wafer-space/chip-on-board-wire-bonded-pcbs/run-2/1x0p5-cob/mezzanine-1x0p5.kicad_pcb

## KiCad design run-2/1x0p5-cob/mezzanine-1x0p5.kicad_pcb (2026-10-08)

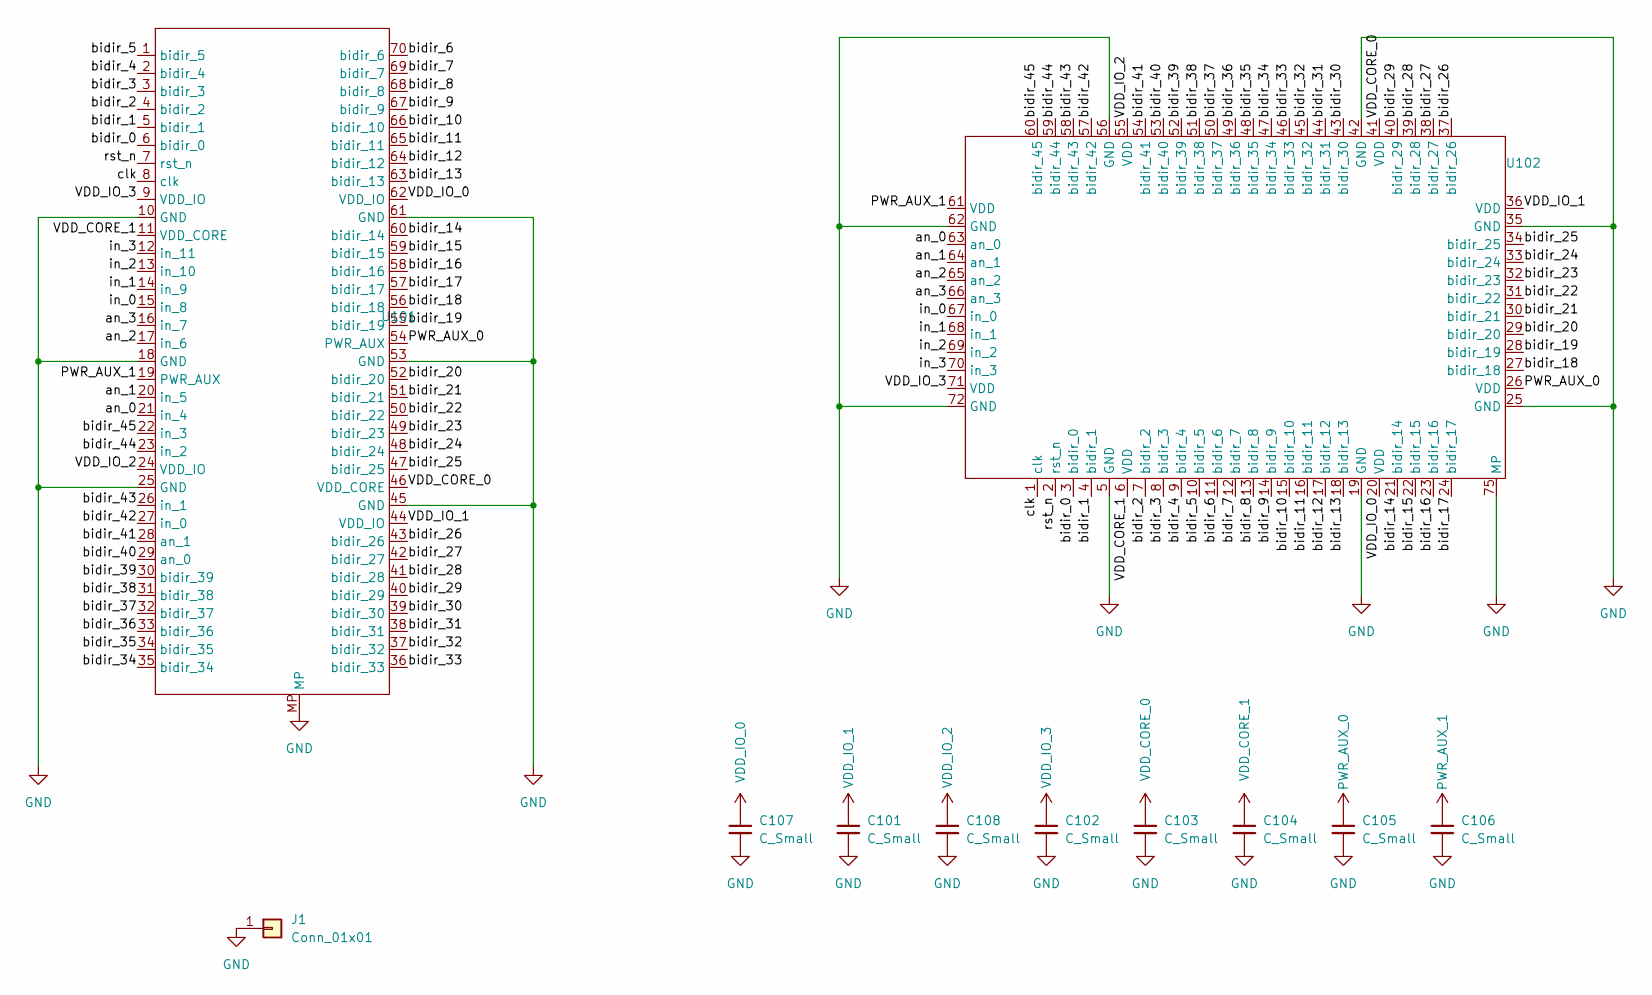
[picture p6: schematic mezzanine-1x0p5.kicad_sch, Wafer Space 1x0p5 mezzanine]

Parts:
C101, C102, C103, C104, C105, C106, C107, C108: C_Small; C_0201_0603Metric
J1: Conn_01x01; pin1_fiducial
U101: CONN-SMD_70P-P0.40_HCTL_HC-PBB40C-70DP-0.4V-02
U102: waferspace_1x0p5_padring_v0.1

Connections:
/an_0: U101.21 (in_4), U102.63 (an_0)
/an_1: U101.20 (in_5), U102.64 (an_1)
/an_2: U101.17 (in_6), U102.65 (an_2)
/an_3: U101.16 (in_7), U102.66 (an_3)
/bidir_0: U101.6 (bidir_0), U102.3 (bidir_0)
/bidir_1: U101.5 (bidir_1), U102.4 (bidir_1)
/bidir_2: U101.4 (bidir_2), U102.7 (bidir_2)
/bidir_3: U101.3 (bidir_3), U102.8 (bidir_3)
/bidir_4: U101.2 (bidir_4), U102.9 (bidir_4)
/bidir_5: U101.1 (bidir_5), U102.10 (bidir_5)
/bidir_6: U101.70 (bidir_6), U102.11 (bidir_6)
/bidir_7: U101.69 (bidir_7), U102.12 (bidir_7)
/bidir_8: U101.68 (bidir_8), U102.13 (bidir_8)
/bidir_9: U101.67 (bidir_9), U102.14 (bidir_9)
/bidir_10: U101.66 (bidir_10), U102.15 (bidir_10)
/bidir_11: U101.65 (bidir_11), U102.16 (bidir_11)
/bidir_12: U101.64 (bidir_12), U102.17 (bidir_12)
/bidir_13: U101.63 (bidir_13), U102.18 (bidir_13)
/bidir_14: U101.60 (bidir_14), U102.21 (bidir_14)
/bidir_15: U101.59 (bidir_15), U102.22 (bidir_15)
/bidir_16: U101.58 (bidir_16), U102.23 (bidir_16)
/bidir_17: U101.57 (bidir_17), U102.24 (bidir_17)
/bidir_18: U101.56 (bidir_18), U102.27 (bidir_18)
/bidir_19: U101.55 (bidir_19), U102.28 (bidir_19)
/bidir_20: U101.52 (bidir_20), U102.29 (bidir_20)
/bidir_21: U101.51 (bidir_21), U102.30 (bidir_21)
/bidir_22: U101.50 (bidir_22), U102.31 (bidir_22)
/bidir_23: U101.49 (bidir_23), U102.32 (bidir_23)
/bidir_24: U101.48 (bidir_24), U102.33 (bidir_24)
/bidir_25: U101.47 (bidir_25), U102.34 (bidir_25)
/bidir_26: U101.43 (bidir_26), U102.37 (bidir_26)
/bidir_27: U101.42 (bidir_27), U102.38 (bidir_27)
/bidir_28: U101.41 (bidir_28), U102.39 (bidir_28)
/bidir_29: U101.40 (bidir_29), U102.40 (bidir_29)
/bidir_30: U101.39 (bidir_30), U102.43 (bidir_30)
/bidir_31: U101.38 (bidir_31), U102.44 (bidir_31)
/bidir_32: U101.37 (bidir_32), U102.45 (bidir_32)
/bidir_33: U101.36 (bidir_33), U102.46 (bidir_33)
/bidir_34: U101.35 (bidir_34), U102.47 (bidir_34)
/bidir_35: U101.34 (bidir_35), U102.48 (bidir_35)
/bidir_36: U101.33 (bidir_36), U102.49 (bidir_36)
/bidir_37: U101.32 (bidir_37), U102.50 (bidir_37)
/bidir_38: U101.31 (bidir_38), U102.51 (bidir_38)
/bidir_39: U101.30 (bidir_39), U102.52 (bidir_39)
/bidir_40: U101.29 (an_0), U102.53 (bidir_40)
/bidir_41: U101.28 (an_1), U102.54 (bidir_41)
/bidir_42: U101.27 (in_0), U102.57 (bidir_42)
/bidir_43: U101.26 (in_1), U102.58 (bidir_43)
/bidir_44: U101.23 (in_2), U102.59 (bidir_44)
/bidir_45: U101.22 (in_3), U102.60 (bidir_45)
/clk: U101.8 (clk), U102.1 (clk)
/in_0: U101.15 (in_8), U102.67 (in_0)
/in_1: U101.14 (in_9), U102.68 (in_1)
/in_2: U101.13 (in_10), U102.69 (in_2)
/in_3: U101.12 (in_11), U102.70 (in_3)
/rst_n: U101.7 (rst_n), U102.2 (rst_n)
GND: C101.2, C102.2, C103.2, C104.2, C105.2, C106.2, C107.2, C108.2, J1.1 (Pin_1_1), U101.10 (GND), U101.18 (GND), U101.25 (GND), U101.45 (GND), U101.53 (GND), U101.61 (GND), U101.MP, U102.5 (GND), U102.19 (GND), U102.25 (GND), U102.35 (GND), U102.42 (GND), U102.56 (GND), U102.62 (GND), U102.72 (GND), U102.75 (MP)
PWR_AUX_0: C105.1, U101.54 (PWR_AUX), U102.26 (VDD)
PWR_AUX_1: C106.1, U101.19 (PWR_AUX), U102.61 (VDD)
VDD_CORE_0: C103.1, U101.46 (VDD_CORE), U102.41 (VDD)
VDD_CORE_1: C104.1, U101.11 (VDD_CORE), U102.6 (VDD)
VDD_IO_0: C107.1, U101.62 (VDD_IO), U102.20 (VDD)
VDD_IO_1: C101.1, U101.44 (VDD_IO), U102.36 (VDD)
VDD_IO_2: C108.1, U101.24 (VDD_IO), U102.55 (VDD)
VDD_IO_3: C102.1, U101.9 (VDD_IO), U102.71 (VDD)

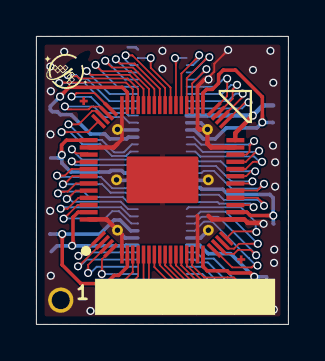
[picture p7: board mezzanine-1x0p5.kicad_pcb from above]

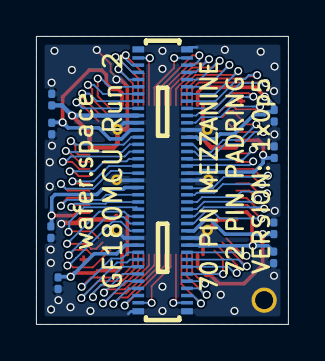
[picture p8: board mezzanine-1x0p5.kicad_pcb from below]

Board: 4 copper layers, 14.0 x 16.0 mm, 11 parts (9 on the bottom side), 65 nets.
