wafer-space/chip-on-board-wire-bonded-pcbs/run-1/motherboards/motherboards.kicad_pcb

## KiCad design run-1/motherboards/motherboards.kicad_pcb (2026-06-16)

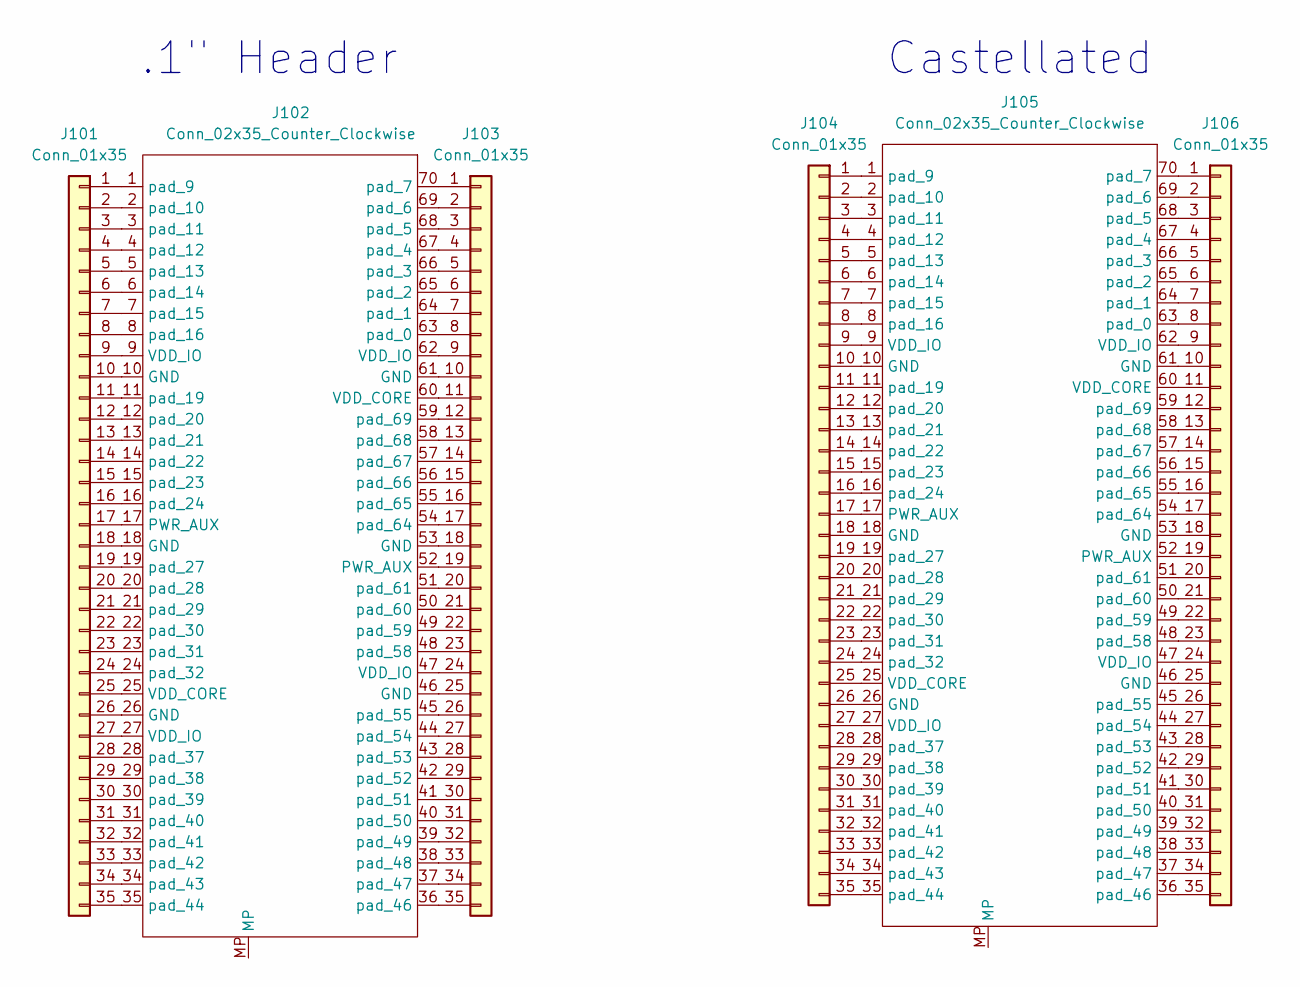
[picture p9: schematic motherboards.kicad_sch]

Parts:
J101, J103: Conn_01x35; PinHeader_1x35_P2.54mm_Vertical
J102, J105: Conn_02x35_Counter_Clockwise; CONN-SMD_70P-P0.40_HCTL_HC-PBB40C-70DP-0.4V-02
J104, J106: Conn_01x35; castellated_1mmx35

Connections:
unnamed: J101.1, J102.1 (pad_9)
unnamed: J101.2, J102.2 (pad_10)
unnamed: J101.3, J102.3 (pad_11)
unnamed: J101.4, J102.4 (pad_12)
unnamed: J101.5, J102.5 (pad_13)
unnamed: J101.6, J102.6 (pad_14)
unnamed: J101.7, J102.7 (pad_15)
unnamed: J101.8, J102.8 (pad_16)
unnamed: J101.9, J102.9 (VDD_IO)
unnamed: J101.10, J102.10 (GND)
unnamed: J101.11, J102.11 (pad_19)
unnamed: J101.12, J102.12 (pad_20)
unnamed: J101.13, J102.13 (pad_21)
unnamed: J101.14, J102.14 (pad_22)
unnamed: J101.15, J102.15 (pad_23)
unnamed: J101.16, J102.16 (pad_24)
unnamed: J101.17, J102.17 (PWR_AUX)
unnamed: J101.18, J102.18 (GND)
unnamed: J101.19, J102.19 (pad_27)
unnamed: J101.20, J102.20 (pad_28)
unnamed: J101.21, J102.21 (pad_29)
unnamed: J101.22, J102.22 (pad_30)
unnamed: J101.23, J102.23 (pad_31)
unnamed: J101.24, J102.24 (pad_32)
unnamed: J101.25, J102.25 (VDD_CORE)
unnamed: J101.26, J102.26 (GND)
unnamed: J101.27, J102.27 (VDD_IO)
unnamed: J101.28, J102.28 (pad_37)
unnamed: J101.29, J102.29 (pad_38)
unnamed: J101.30, J102.30 (pad_39)
unnamed: J101.31, J102.31 (pad_40)
unnamed: J101.32, J102.32 (pad_41)
unnamed: J101.33, J102.33 (pad_42)
unnamed: J101.34, J102.34 (pad_43)
unnamed: J101.35, J102.35 (pad_44)
unnamed: J102.63 (pad_0), J103.8
unnamed: J102.64 (pad_1), J103.7
unnamed: J102.65 (pad_2), J103.6
unnamed: J102.66 (pad_3), J103.5
unnamed: J102.67 (pad_4), J103.4
unnamed: J102.68 (pad_5), J103.3
unnamed: J102.69 (pad_6), J103.2
unnamed: J102.70 (pad_7), J103.1
unnamed: J102.36 (pad_46), J103.35
unnamed: J102.37 (pad_47), J103.34
unnamed: J102.38 (pad_48), J103.33
unnamed: J102.39 (pad_49), J103.32
unnamed: J102.40 (pad_50), J103.31
unnamed: J102.41 (pad_51), J103.30
unnamed: J102.42 (pad_52), J103.29
unnamed: J102.43 (pad_53), J103.28
unnamed: J102.44 (pad_54), J103.27
unnamed: J102.45 (pad_55), J103.26
unnamed: J102.48 (pad_58), J103.23
unnamed: J102.49 (pad_59), J103.22
unnamed: J102.50 (pad_60), J103.21
unnamed: J102.51 (pad_61), J103.20
unnamed: J102.54 (pad_64), J103.17
unnamed: J102.55 (pad_65), J103.16
unnamed: J102.56 (pad_66), J103.15
unnamed: J102.57 (pad_67), J103.14
unnamed: J102.58 (pad_68), J103.13
unnamed: J102.59 (pad_69), J103.12
unnamed: J102.62 (VDD_IO), J103.9
unnamed: J102.61 (GND), J103.10
unnamed: J102.60 (VDD_CORE), J103.11
unnamed: J102.53 (GND), J103.18
unnamed: J102.52 (PWR_AUX), J103.19
unnamed: J102.47 (VDD_IO), J103.24
unnamed: J102.46 (GND), J103.25
unnamed: J104.1, J105.1 (pad_9)
unnamed: J104.2, J105.2 (pad_10)
unnamed: J104.3, J105.3 (pad_11)
unnamed: J104.4, J105.4 (pad_12)
unnamed: J104.5, J105.5 (pad_13)
unnamed: J104.6, J105.6 (pad_14)
unnamed: J104.7, J105.7 (pad_15)
unnamed: J104.8, J105.8 (pad_16)
unnamed: J104.9, J105.9 (VDD_IO)
unnamed: J104.10, J105.10 (GND)
unnamed: J104.11, J105.11 (pad_19)
unnamed: J104.12, J105.12 (pad_20)
unnamed: J104.13, J105.13 (pad_21)
unnamed: J104.14, J105.14 (pad_22)
unnamed: J104.15, J105.15 (pad_23)
unnamed: J104.16, J105.16 (pad_24)
unnamed: J104.17, J105.17 (PWR_AUX)
unnamed: J104.18, J105.18 (GND)
unnamed: J104.19, J105.19 (pad_27)
unnamed: J104.20, J105.20 (pad_28)
unnamed: J104.21, J105.21 (pad_29)
unnamed: J104.22, J105.22 (pad_30)
unnamed: J104.23, J105.23 (pad_31)
unnamed: J104.24, J105.24 (pad_32)
unnamed: J104.25, J105.25 (VDD_CORE)
unnamed: J104.26, J105.26 (GND)
unnamed: J104.27, J105.27 (VDD_IO)
unnamed: J104.28, J105.28 (pad_37)
unnamed: J104.29, J105.29 (pad_38)
unnamed: J104.30, J105.30 (pad_39)
unnamed: J104.31, J105.31 (pad_40)
unnamed: J104.32, J105.32 (pad_41)
unnamed: J104.33, J105.33 (pad_42)
unnamed: J104.34, J105.34 (pad_43)
unnamed: J104.35, J105.35 (pad_44)
unnamed: J105.63 (pad_0), J106.8
unnamed: J105.64 (pad_1), J106.7
unnamed: J105.65 (pad_2), J106.6
unnamed: J105.66 (pad_3), J106.5
unnamed: J105.67 (pad_4), J106.4
unnamed: J105.68 (pad_5), J106.3
unnamed: J105.69 (pad_6), J106.2
unnamed: J105.70 (pad_7), J106.1
unnamed: J105.36 (pad_46), J106.35
unnamed: J105.37 (pad_47), J106.34
unnamed: J105.38 (pad_48), J106.33
unnamed: J105.39 (pad_49), J106.32
unnamed: J105.40 (pad_50), J106.31
unnamed: J105.41 (pad_51), J106.30
unnamed: J105.42 (pad_52), J106.29
unnamed: J105.43 (pad_53), J106.28
unnamed: J105.44 (pad_54), J106.27
unnamed: J105.45 (pad_55), J106.26
unnamed: J105.48 (pad_58), J106.23
unnamed: J105.49 (pad_59), J106.22
unnamed: J105.50 (pad_60), J106.21
unnamed: J105.51 (pad_61), J106.20
unnamed: J105.54 (pad_64), J106.17
unnamed: J105.55 (pad_65), J106.16
unnamed: J105.56 (pad_66), J106.15
unnamed: J105.57 (pad_67), J106.14
unnamed: J105.58 (pad_68), J106.13
unnamed: J105.59 (pad_69), J106.12
unnamed: J105.62 (VDD_IO), J106.9
unnamed: J105.61 (GND), J106.10
unnamed: J105.60 (VDD_CORE), J106.11
unnamed: J105.53 (GND), J106.18
unnamed: J105.52 (PWR_AUX), J106.19
unnamed: J105.47 (VDD_IO), J106.24
unnamed: J105.46 (GND), J106.25

Notes on the sheet:
Castellated
.1" Header

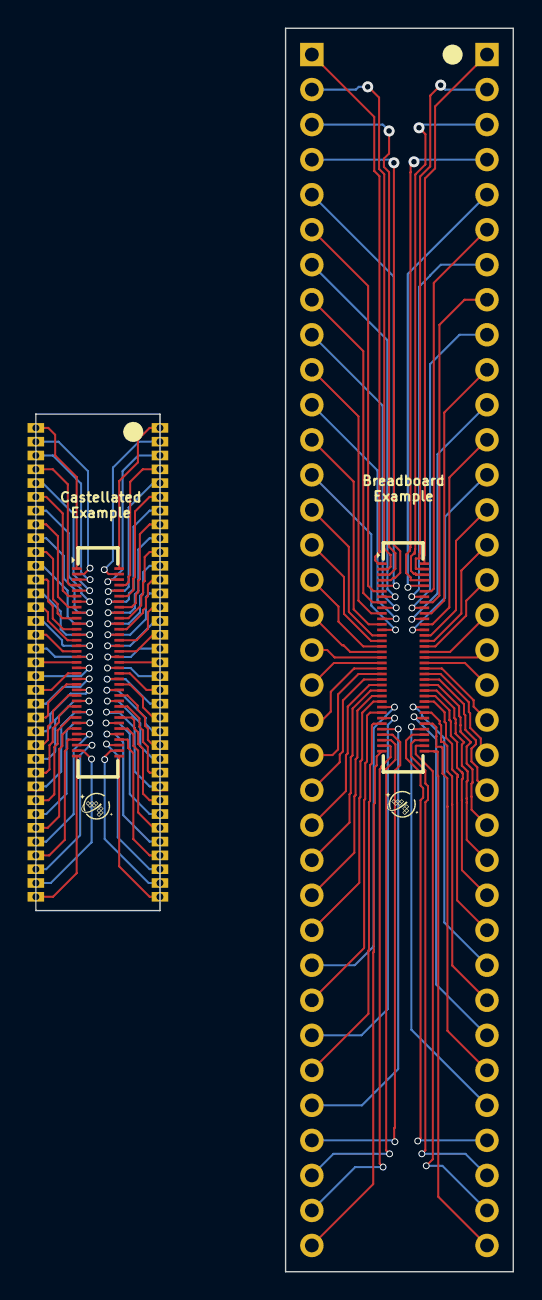
[picture p10: board run-1/motherboards/motherboards.kicad_pcb from above]

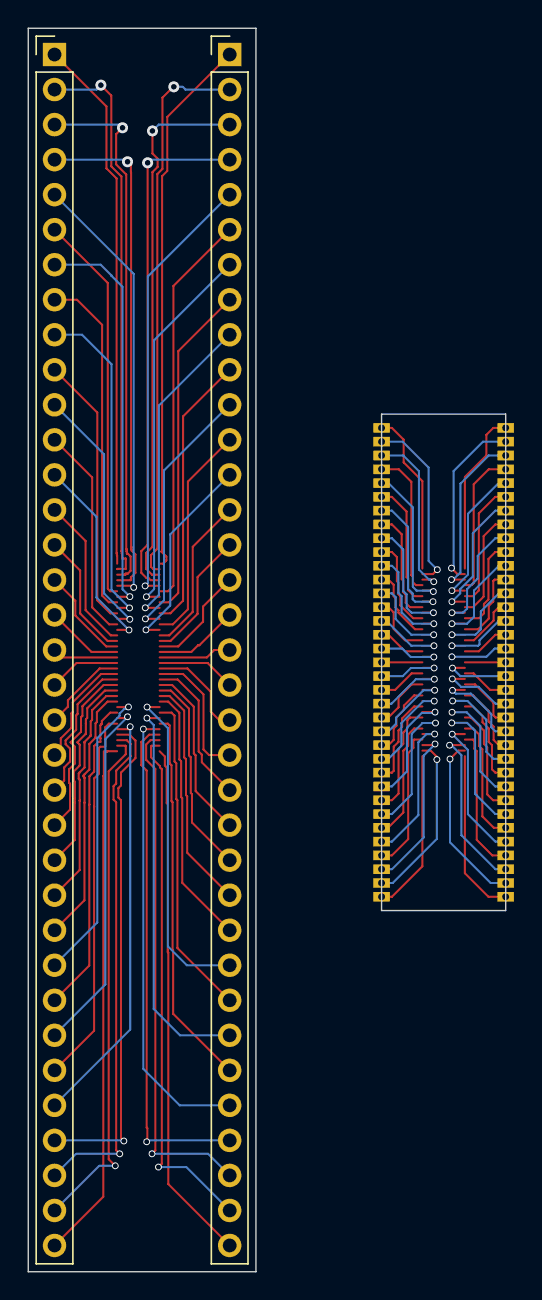
[picture p11: board run-1/motherboards/motherboards.kicad_pcb from below]

Board: 2 copper layers, 34.6 x 90.2 mm, 6 parts (2 on the bottom side), 140 nets.
