wafer-space/chip-on-board-wire-bonded-pcbs/scratch/motherboards/motherboards/motherboards.kicad_pcb

## KiCad design scratch/motherboards/motherboards/motherboards.kicad_pcb (2025-11-23, an earlier design)

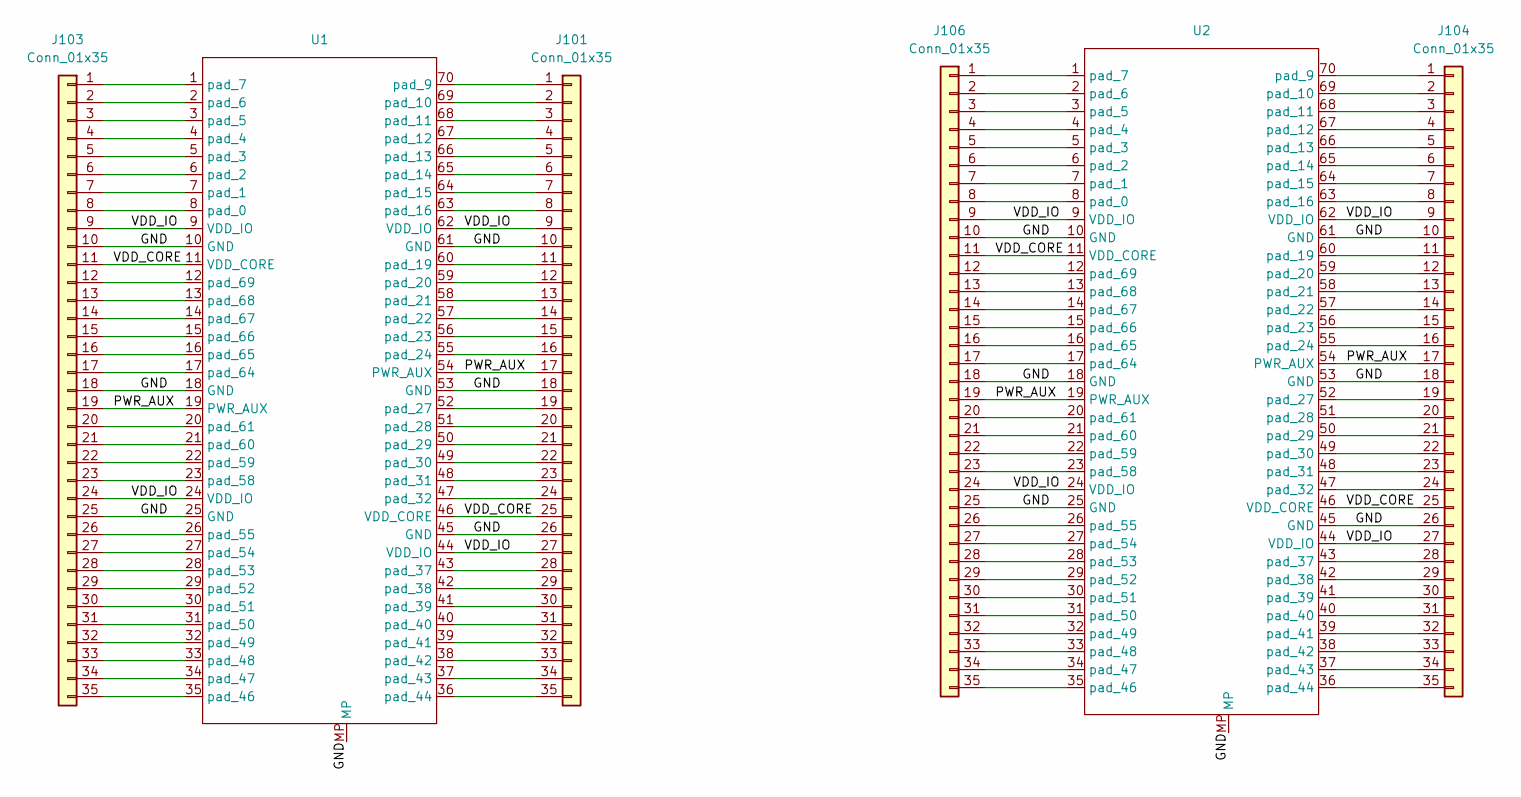
[picture p12: schematic motherboards.kicad_sch]

Parts:
J101, J103: Conn_01x35; PinHeader_1x35_P2.54mm_Vertical
J104, J106: Conn_01x35; castellated_1mmx35
U1, U2: P0.40_HC-PBB40C-70DS-0.4V-3.0-02_wscob

Connections:
/GND: J101.10, J101.18, J101.26, J103.10, J103.18, J103.25, J104.10, J104.18, J104.26, J106.10, J106.18, J106.25, U1.10 (GND), U1.18 (GND), U1.25 (GND), U1.45 (GND), U1.53 (GND), U1.61 (GND), U1.MP, U2.10 (GND), U2.18 (GND), U2.25 (GND), U2.45 (GND), U2.53 (GND), U2.61 (GND), U2.MP
/PWR_AUX: J101.17, J103.19, J104.17, J106.19, U1.19 (PWR_AUX), U1.54 (PWR_AUX), U2.19 (PWR_AUX), U2.54 (PWR_AUX)
/VDD_CORE: J101.25, J103.11, J104.25, J106.11, U1.11 (VDD_CORE), U1.46 (VDD_CORE), U2.11 (VDD_CORE), U2.46 (VDD_CORE)
/VDD_IO: J101.9, J101.27, J103.9, J103.24, J104.9, J104.27, J106.9, J106.24, U1.9 (VDD_IO), U1.24 (VDD_IO), U1.44 (VDD_IO), U1.62 (VDD_IO), U2.9 (VDD_IO), U2.24 (VDD_IO), U2.44 (VDD_IO), U2.62 (VDD_IO)
unnamed: J101.1, U1.70 (pad_9)
unnamed: J101.2, U1.69 (pad_10)
unnamed: J101.3, U1.68 (pad_11)
unnamed: J101.4, U1.67 (pad_12)
unnamed: J101.5, U1.66 (pad_13)
unnamed: J101.6, U1.65 (pad_14)
unnamed: J101.7, U1.64 (pad_15)
unnamed: J101.8, U1.63 (pad_16)
unnamed: J101.11, U1.60 (pad_19)
unnamed: J101.12, U1.59 (pad_20)
unnamed: J101.13, U1.58 (pad_21)
unnamed: J101.14, U1.57 (pad_22)
unnamed: J101.15, U1.56 (pad_23)
unnamed: J101.16, U1.55 (pad_24)
unnamed: J101.19, U1.52 (pad_27)
unnamed: J101.20, U1.51 (pad_28)
unnamed: J101.21, U1.50 (pad_29)
unnamed: J101.22, U1.49 (pad_30)
unnamed: J101.23, U1.48 (pad_31)
unnamed: J101.24, U1.47 (pad_32)
unnamed: J101.28, U1.43 (pad_37)
unnamed: J101.29, U1.42 (pad_38)
unnamed: J101.30, U1.41 (pad_39)
unnamed: J101.31, U1.40 (pad_40)
unnamed: J101.32, U1.39 (pad_41)
unnamed: J101.33, U1.38 (pad_42)
unnamed: J101.34, U1.37 (pad_43)
unnamed: J101.35, U1.36 (pad_44)
unnamed: J103.1, U1.1 (pad_7)
unnamed: J103.2, U1.2 (pad_6)
unnamed: J103.3, U1.3 (pad_5)
unnamed: J103.4, U1.4 (pad_4)
unnamed: J103.5, U1.5 (pad_3)
unnamed: J103.6, U1.6 (pad_2)
unnamed: J103.7, U1.7 (pad_1)
unnamed: J103.8, U1.8 (pad_0)
unnamed: J103.12, U1.12 (pad_69)
unnamed: J103.13, U1.13 (pad_68)
unnamed: J103.14, U1.14 (pad_67)
unnamed: J103.15, U1.15 (pad_66)
unnamed: J103.16, U1.16 (pad_65)
unnamed: J103.17, U1.17 (pad_64)
unnamed: J103.20, U1.20 (pad_61)
unnamed: J103.21, U1.21 (pad_60)
unnamed: J103.22, U1.22 (pad_59)
unnamed: J103.23, U1.23 (pad_58)
unnamed: J103.26, U1.26 (pad_55)
unnamed: J103.27, U1.27 (pad_54)
unnamed: J103.28, U1.28 (pad_53)
unnamed: J103.29, U1.29 (pad_52)
unnamed: J103.30, U1.30 (pad_51)
unnamed: J103.31, U1.31 (pad_50)
unnamed: J103.32, U1.32 (pad_49)
unnamed: J103.33, U1.33 (pad_48)
unnamed: J103.34, U1.34 (pad_47)
unnamed: J103.35, U1.35 (pad_46)
unnamed: J104.1, U2.70 (pad_9)
unnamed: J104.2, U2.69 (pad_10)
unnamed: J104.3, U2.68 (pad_11)
unnamed: J104.4, U2.67 (pad_12)
unnamed: J104.5, U2.66 (pad_13)
unnamed: J104.6, U2.65 (pad_14)
unnamed: J104.7, U2.64 (pad_15)
unnamed: J104.8, U2.63 (pad_16)
unnamed: J104.11, U2.60 (pad_19)
unnamed: J104.12, U2.59 (pad_20)
unnamed: J104.13, U2.58 (pad_21)
unnamed: J104.14, U2.57 (pad_22)
unnamed: J104.15, U2.56 (pad_23)
unnamed: J104.16, U2.55 (pad_24)
unnamed: J104.19, U2.52 (pad_27)
unnamed: J104.20, U2.51 (pad_28)
unnamed: J104.21, U2.50 (pad_29)
unnamed: J104.22, U2.49 (pad_30)
unnamed: J104.23, U2.48 (pad_31)
unnamed: J104.24, U2.47 (pad_32)
unnamed: J104.28, U2.43 (pad_37)
unnamed: J104.29, U2.42 (pad_38)
unnamed: J104.30, U2.41 (pad_39)
unnamed: J104.31, U2.40 (pad_40)
unnamed: J104.32, U2.39 (pad_41)
unnamed: J104.33, U2.38 (pad_42)
unnamed: J104.34, U2.37 (pad_43)
unnamed: J104.35, U2.36 (pad_44)
unnamed: J106.1, U2.1 (pad_7)
unnamed: J106.2, U2.2 (pad_6)
unnamed: J106.3, U2.3 (pad_5)
unnamed: J106.4, U2.4 (pad_4)
unnamed: J106.5, U2.5 (pad_3)
unnamed: J106.6, U2.6 (pad_2)
unnamed: J106.7, U2.7 (pad_1)
unnamed: J106.8, U2.8 (pad_0)
unnamed: J106.12, U2.12 (pad_69)
unnamed: J106.13, U2.13 (pad_68)
unnamed: J106.14, U2.14 (pad_67)
unnamed: J106.15, U2.15 (pad_66)
unnamed: J106.16, U2.16 (pad_65)
unnamed: J106.17, U2.17 (pad_64)
unnamed: J106.20, U2.20 (pad_61)
unnamed: J106.21, U2.21 (pad_60)
unnamed: J106.22, U2.22 (pad_59)
unnamed: J106.23, U2.23 (pad_58)
unnamed: J106.26, U2.26 (pad_55)
unnamed: J106.27, U2.27 (pad_54)
unnamed: J106.28, U2.28 (pad_53)
unnamed: J106.29, U2.29 (pad_52)
unnamed: J106.30, U2.30 (pad_51)
unnamed: J106.31, U2.31 (pad_50)
unnamed: J106.32, U2.32 (pad_49)
unnamed: J106.33, U2.33 (pad_48)
unnamed: J106.34, U2.34 (pad_47)
unnamed: J106.35, U2.35 (pad_46)

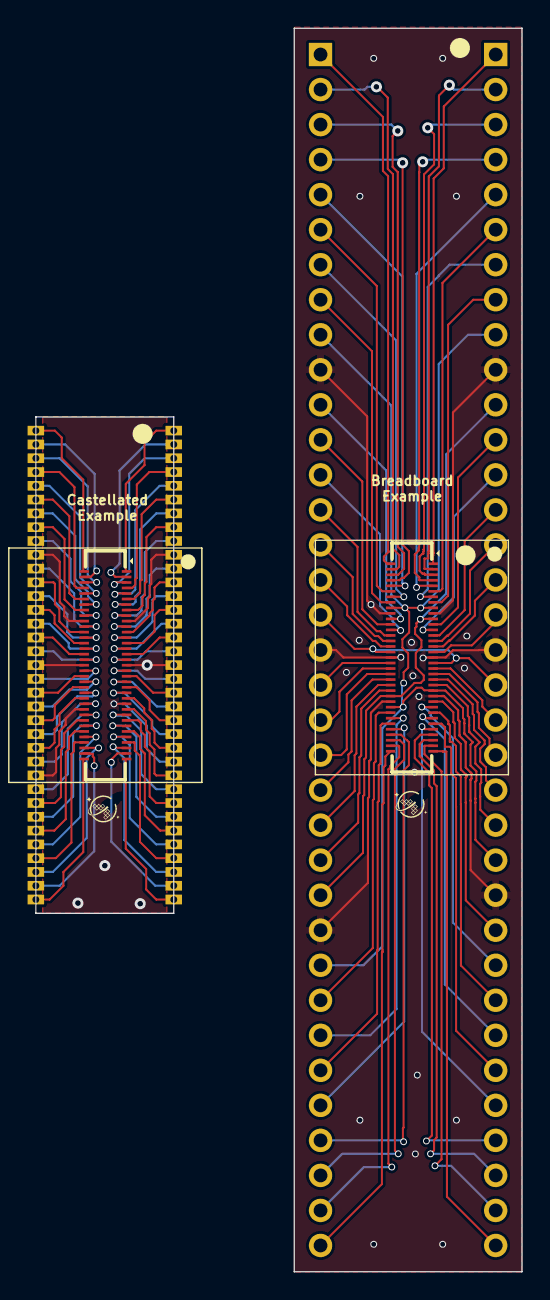
[picture p13: board scratch/motherboards/motherboards/motherboards.kicad_pcb from above]

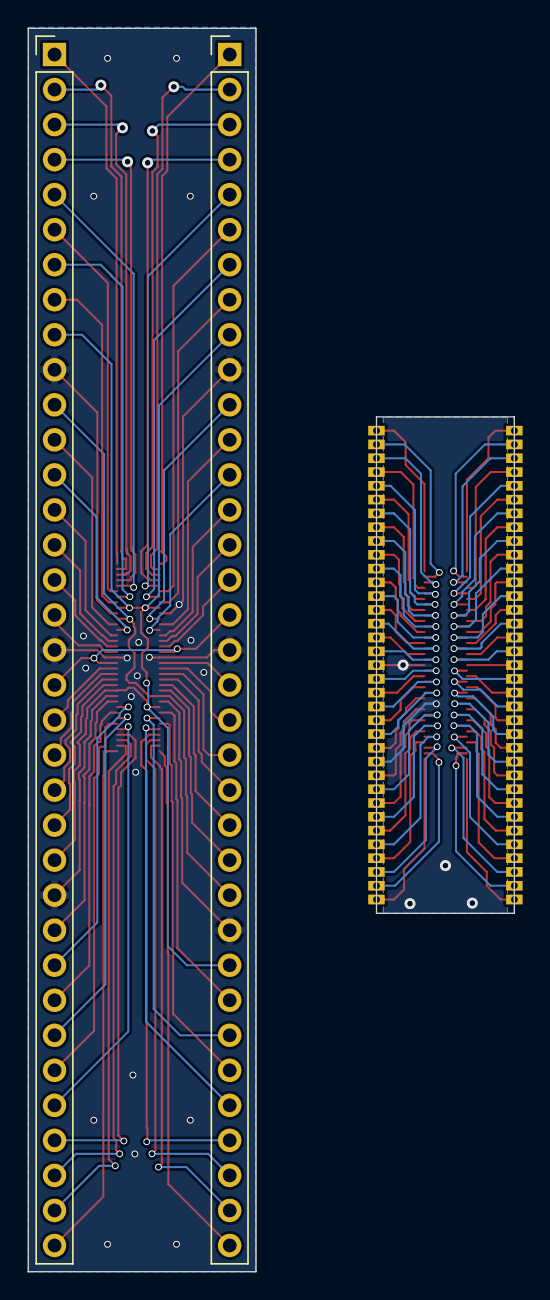
[picture p14: board scratch/motherboards/motherboards/motherboards.kicad_pcb from below]

Board: 2 copper layers, 35.2 x 90.2 mm, 6 parts (2 on the bottom side), 116 nets.
